minamonra/kicad-footprints/README.md

# kicad-footprints
some my KiCad footprints

DPAK from https://github.com/savenlid/kicad/tree/master/footprints/DPAK
