minamonra/kicad-footprints/3dother/User Library-DIP4-7_62-2_54.STEP

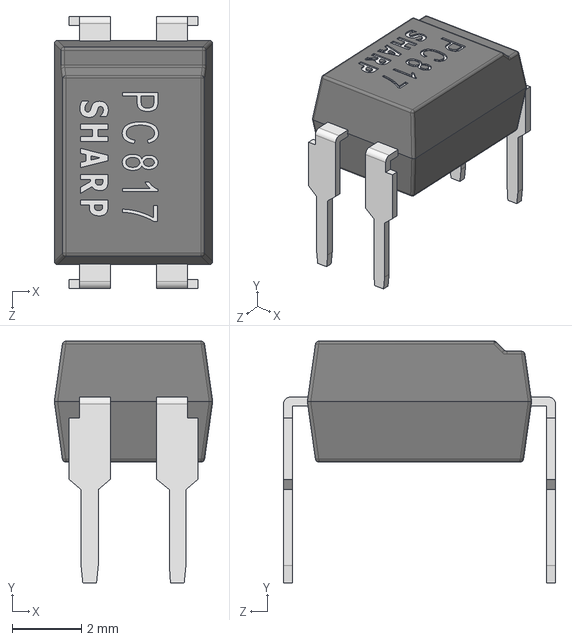
[picture p1: CAD file, 2026-02-04]
3dother/User Library-DIP4-7_62-2_54.STEP
4.59 x 7.00 x 7.88 mm
