minamonra/kicad-footprints/_aModules/3D/MSP3526_3D.step

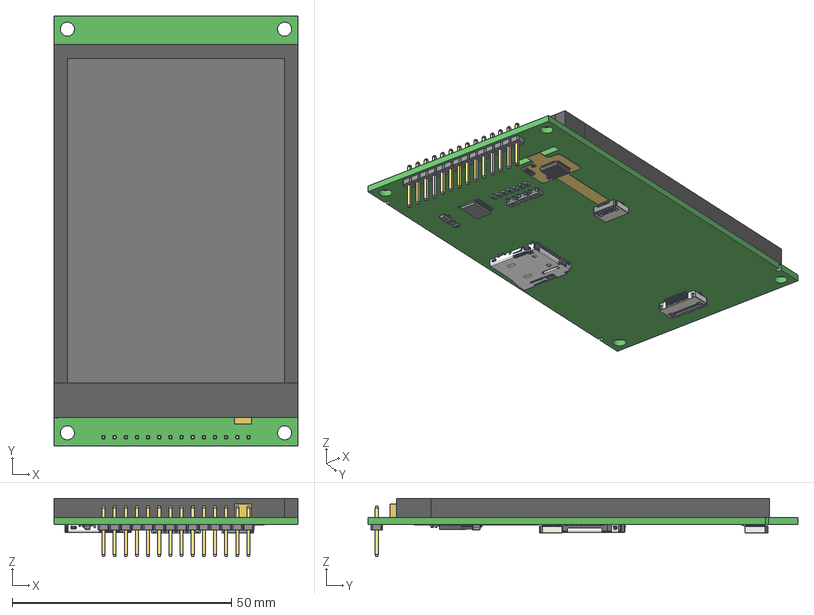
[picture p2: CAD file, 2026-09-08]
_aModules/3D/MSP3526_3D.step
55.5 x 98.0 x 13.2 mm
SW3dPS-TSSOP20
SW3dPS-3-lead_sot23-3
User_Library-MEM2055-00-190-01-A_revG
User_Library-CR1005-0402 x 2
User_Library-SOT95P280X135-3M[SOT23_TO-236AA] x 3
FPC0.5_2H-W_竘褐 x 20
LOGO?0.25 x 2
FPC0.5_2H-S-W-6P
HDR2.54-1P x 14
LOGO? x 14
FPC0.5_2H-S-W-14P
Extruded x 50
