minamonra/kicad-footprints/DPAK/3D/369A.step

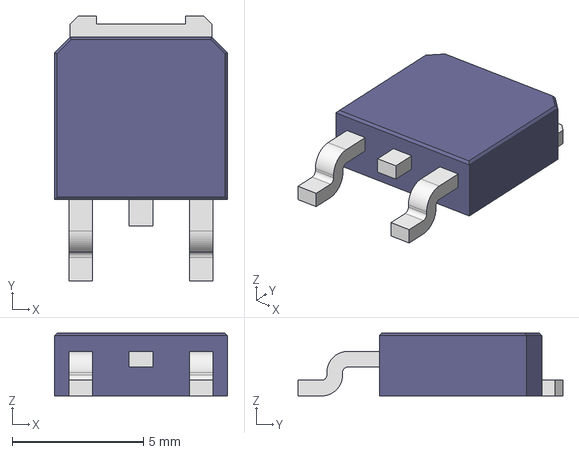
[picture p3: CAD file, 2023-10-02]
DPAK/3D/369A.step
6.60 x 10.1 x 2.40 mm
