minamonra/kicad-footprints/DPAK/3D/DPAK_TO-252AA-3p.step

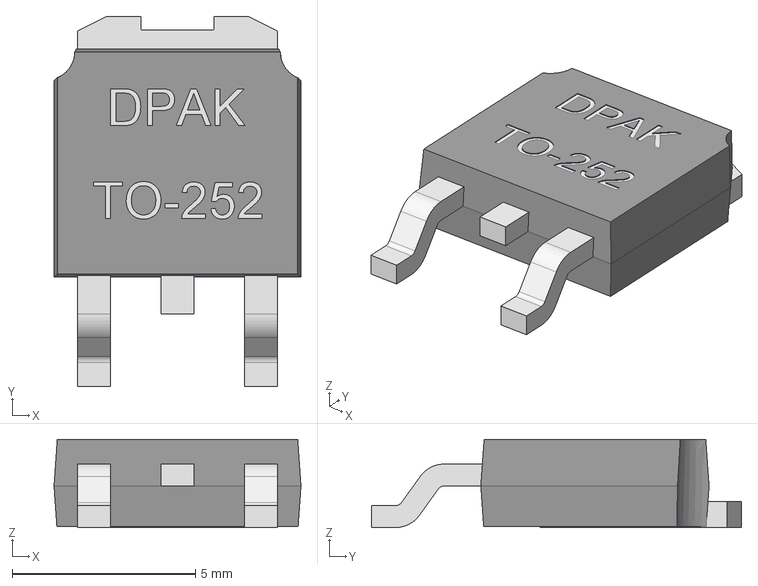
[picture p4: CAD file, 2023-10-02]
DPAK/3D/DPAK_TO-252AA-3p.step
6.73 x 10.1 x 2.40 mm
