minamonra/kicad-footprints/(list of files, cad)

Other CAD files:
_aModules/3D/MiniF4x1Cx_V31_3D.step
